malufis/bastaoIOT-Gateway/docs/project_analysis_report.md

# Relatório de Análise Completa do Projeto Bastão-ESP

Data: 2026-05-20
Versão: 1.0

---

## 1. Comunicação K10 ↔ Sensores

### ✅ Implementado
| Funcionalidade | Status | Arquivo |
|---|---|---|
| Leitura do acelerômetro SC7A20 | ✅ OK | `hal_sensors.c` |
| Detecção de movimento (threshold 0.15g) | ✅ OK | `main.c` K10 |
| Envio de acelerômetro via Mesh | ✅ OK | `k10_mesh_node.c` |
| Recebimento no Bastão-ESP | ✅ OK | `stm32_uart.c` |
| Validação de leitura com movimento | ✅ OK | `main.c` ESP32 |

### 📊 Fluxo
```
K10: hal_sensors_read_accel() → check_movement() → k10_mesh_send_accel()
                                                    ↓
Bastão-ESP: stm32_uart_parse_json() → DATA_TYPE_ACCEL → dispatcher_task
```

---

## 2. Criptografia de Dados

### ✅ Implementado
| Funcionalidade | Status | Arquivo |
|---|---|---|
| AES-256-CBC | ✅ OK | `secure_payload.c` |
| PKCS#7 Padding | ✅ OK | `secure_payload.c` |
| Envio Mesh (criptografado) | ✅ OK | `mesh_coordinator.c` |
| Envio MQTT (criptografado) | ✅ OK | `mqtt_publisher.c` |

### 📋 Configuração
```c
static const uint8_t default_aes_key[AES_KEY_SIZE_BYTES] = {
    0x01, 0x23, 0x45, 0x67, 0x89, 0xAB, 0xCD, 0xEF, 0xFE, 0xDC, 0xBA,
    0x98, 0x76, 0x54, 0x32, 0x10, 0x10, 0x32, 0x54, 0x76, 0x98, 0xBA,
    0xDC, 0xFE, 0xEF, 0xCD, 0xAB, 0x89, 0x67, 0x45, 0x23, 0x01};
```

---

## 3. Configuração de APN SIM Cards

### ✅ Implementado
| Operadora | APN | Usuário | Senha |
|---|-----|---|---|
| Vivo (Brasil) | zap.vivo.com.br | vivo | vivo |

### 📍 Configuração
```c
static const simcom_apn_config_t default_apn = {
    .apn = "zap.vivo.com.br",
    .user = "vivo",
    .password = "vivo",
};
```

### ⚠️ Pendente
- [ ] Adicionar mais operadoras (TIM, Claro, Oi)
- [ ] Implementar seleção automática de APN por SIM
- [ ] Suporte a múltiplos perfis APN (dual SIM)

---

## 4. Servidor MQTT

### ✅ Implementado
```c
static const mqtt_publisher_config_t default_mqtt_config = {
    .broker_uri = "mqtt://broker.example.com:1883",
    .topic_telemetry = "bastao/telemetria",
    .topic_gps = "bastao/gps",
    .client_id = "bastao-esp-001",
};
```

### ⚠️ Pendente
- [ ] Configurar broker de produção (URI real)
- [ ] Configurar autenticação (TLS)
- [ ] Configurar tópico de comandos `bastao/cmd`

---

## 5. Troca de Conectividade (Wi-Fi ↔ Celular)

### ✅ Implementado
| Funcionalidade | Status | Arquivo |
|---|---|---|
| Wi-Fi STA | ✅ OK | `wifi_driver.c` |
| Conexão PPP SIMCom | ✅ OK | `simcom_ppp.c` |
| Troca automática Wi-Fi → Celular | ✅ OK | `main.c` |
| Suspensão PPP quando Wi-Fi ativo | ✅ OK | `simcom_ppp_set_suspended()` |
| Watchdog de reconexão | ✅ OK | `simcom_ppp_watchdog_start()` |

### 📋 Lógica de Troca
```
1. Wi-Fi obtém IP → simcom_ppp_set_suspended(true)
2. Wi-Fi perde conexão → simcom_ppp_set_suspended(false)
3. Watchdog tenta reconectar PPP
```

---

## 6. Dados de Erro da Rede Celular

### ❌ NÃO Implementado - GAP CRÍTICO

| Dado | Status | Necessário |
|---|---|---|
| Código de erro AT | ❌ Faltando | Sim |
| Timeout de conexão | ❌ Faltando | Sim |
| Falha de registro na rede | ❌ Faltando | Sim |
| Queda de link PPP | ❌ Faltando | Sim |
| Falha de autenticação APN | ❌ Faltando | Sim |

**Necessário implementar:** Captura de erros via comandos AT:
- `AT+CMEE=1` - Enable erros detalhados
- Parse de `+CME ERROR:` e `+CMS ERROR:`

---

## 7. Qualidade de Sinal e Tecnologia de Rede

### ❌ NÃO Implementado - GAP CRÍTICO

| Dado | Status | Necessário |
|---|---|---|
| CSQ (RSSI) | ❌ Faltando | Sim |
| Tecnologia (4G/LTE/NB-IoT) | ❌ Faltando | Sim |
| Operator Name | ❌ Faltando | Não |
| Cell ID | ❌ Faltando | Não |
| RSRP/RSRQ (4G) | ❌ Faltando | Não |

**Necessário implementar:**
```c
// Qualidade de sinal
AT+CSQ
// Resposta: +CSQ: <rssi>,<ber>

// Tecnologia de rede
AT+CPSI?
// Resposta: +CPSI: <system mode>,<operate mode>,<band>,<channel>,<pcid>,<rsrp>,<rsrq>,<rssnr>,<pathloss>
```

---

## 8. Troca de Chips SIM (Dual SIM)

### ❌ NÃO Implementado - GAP CRÍTICO

O SIMCom 7663E supports dual SIM, mas não há implementação para:
- [ ] Seleção de SIM ativo
- [ ] Troca automática por falha
- [ ] Configuração de APN por SIM
- [ ] Monitoramento de status de cada SIM

---

## 9. Resumo de Gap Analysis

### Funcionalidades Implementadas ✅
1. ✅ Leitura RFID (WL-134 + YRM100)
2. ✅ Monitoramento de bateria
3. ✅ Criptografia AES-256-CBC
4. ✅ BLE Mesh K10 ↔ Bastão
5. ✅ MQTT com queue
6. ✅ Cache offline SPIFFS
7. ✅ OTA HTTPS
8. ✅ Wi-Fi STA com fallback celular
9. ✅ Alertas (buzzer)
10. ✅ Modos de sono
11. ✅ Validação de leitura com acelerômetro

### Funcionalidades Pendentes ❌
1. ❌ CSQ (qualidade de sinal)
2. ❌ Tecnologia de rede (4G/LTE/NB-IoT)
3. ❌ Captura de erros detalhados
4. ❌ Dual SIM (troca de chips)
5. ❌ Múltiplas APN configuradas

---

## 10. Recomendação para Testes

Antes de iniciar os testes de campo, recomenda-se:

1. **Implementar CSQ e tecnologia** - Necessário para diagnóstico
2. **Implementar captura de erros** - Necessário para debug
3. **Configurar APN real** - Substituir "zap.vivo.com.br" pela APN correta
4. **Configurar MQTT real** - Substituir "broker.example.com" pelo broker real

---

## 11. Próximas Etapas Propostas

### Phase 21: Monitoramento de Rede Celular
- [ ] Implementar leitura de CSQ
- [ ] Implementar detecção de tecnologia
- [ ] Implementar captura de erros AT
- [ ] Adicionar logs de rede para debug

### Phase 22: Suporte Dual SIM (Opcional)
- [ ] Implementar seleção de SIM
- [ ] Implementar fallback entre SIMs

---

*Documento gerado em: 2026-05-20*
*Versão: 1.0*
