malufis/bastaoIOT-Gateway/docs/k10/instruções/Instrução ESP Bastao.docx

Vamos trabalhar com esp32 para integração de dados através do sistema de comunicação entre 2 esp32.

A ideia é termos um esp32 que faz a leitura dos dados e envia para um outro esp32 pelo protocolo ESP-MESH onde precisamos definir, se usamos com wifi ou com bluetooth o mesh.

A captura de dados é feito com uma integração entres esp32 e stm32 que se comunicam entre eles pela porta serial ttl.

O esp32 é responsável por toda a parte de conectividade e o stm32 por toda a parte de sensoriamento. Os sensores serão leitores de sinais rfid. Teremos 2 modelos de leitores de rfid, conectado ao stm32 por porta serial ttl, que enviaram dados para o esp32 de tags.

Definição das funcionalidades do STM32

- O Stm32 é responsável em conectar modulo de rfid com a porta serial ttl do leitor de RFID modelo YRM100, com o arquivo anexo com nome Communication user Protocol V2.1_en.docx, que tem toda a documentação do leitor. O Outro leitor é o WL-134, com o arquivo anexo com nome RFID reader module.pdf que são responsáveis pela leitura das tags em tecnologias de leituras distintas.
- O leitor yrm100 será conectado na serial PA0 e PA1 e o wl-134 na serial PA9 e PA10 no mcu STM32G070CBTx que tem o manual técnico no link: https://www.st.com/resource/en/datasheet/stm32g070cb.pdf Para fazer a energizar os módulos yrm100 e o wl-134, é necessário ativar porta digitais com nível logico alto vão está ligado e nível logico baixo desligado. O yrm100 está na porta PB5 e o wl-134 na porta PB4.
- Os módulos tem que enviar o uuid das tags para o esp32 que será responsável de armazenar, processar e disponibilizar os dados via conectividade.
- A porta PB1 é responsável pelo monitoramento da tensão da bateria com circuito resistivo dom r1 de 100k e r2 de 10k.
- Criar um agente que é capaz de tratar de toda a programação dos módulos de rfid com o stm32 para o envio dos dados para o esp32, via porta ttl conectada entre o stm32 e esp32 nas portas PA2 e PA3.

Definição das funcionalidades do ESP32

- Conectividade:
  - O esp32 se comunica com uma tela K10 por meio da tecnologia mesh definida no escopo do projeto. A tela é o endpoint e o modulo deste projeto é o coordenador.
  - O esp32 está ligado via porta serial 17 e18 a um modulo simcom 7663E para a comunicação por celular para os envios dos dados a um servidor mqtt na nuvem.
    - O modulo 7663e é responsável pela conectividade e pela posição gps/glonnas
    - O modulo 7663e usar a tecnologia ppp para ativar a comunicação com o servidor.
    - O esp32 trabalhara com a conectividade do 7663e por ppp e conseguira fazer a comunicação com o servidor mqtt, utilizando a pilha de conectividade do 7663e.
    - Toda as configurações de apn, servidor operadora entre outros sera de responsabilidade do esp32 que enviara os comandos necessários para o modulo 4g poder operar de forma correta.
  - Todos os dados que serão enviados para a tela ou para o servidor serão criptografados com aes padrão do esp32.
  - Utilizaremos o padrão json para o envio dos dados.
  - Toda a comunicação de configuração será feita por protocolo mqtt criptografada.
  - Os módulos esp32 da rede mesh poderão se comunicar entre si e trocar dados entre eles de forma assíncrona.
  - Usaremos o freertos para o sistema. Usaremos o idf da espressif para o desenvolvimento.
- Criar agentes para poder tratar de forma independente cada tipo de mcu, o eps32 e o simcom 7663e

Boas práticas

- Usar boas práticas de programação em C
- Documentar todas as funções.
- Utilizar sempre prototipagem.
- Separar em pasta sempre que preciso os arquivos

Criar um agente para as boas práticas de programação em C.
