malufis/bastaoIOT-Gateway/docs/k10/instruções/Instrução tela k10.docx

agora vamos fazer o planejamento da etapa 2.

Nesta etapa, iremos trabalhar na montagem das telas.
A navegação das telas será pelos botões da K10.

para navegar entre as telas é só apertar, botão para cima vamos para a direita e botão para baixo para a esquerda. Quanto ficarmos 3 segundos do botão de cima pressionado acessar os dados da tela. Depois navegamos com os botões, para cima sobe e para baixo desce. E sempre ter um ícone ou uma linha para sair. Usar a técnica dos 3 segundos para selecionar alguma função dentro da tela.

Primeiro precisamos desligar todos os leds que temos, não iremos usar.

A estrutura das telas são: Tela inicial, Configuração da conectividade, Configuração do dispositivo, Informações do dispositivo.

1. Na tela inicial vamos dividir ela em 3 linhas:
  a. Linha superior iremos mostrar: Icone conectividade celular 4G/3G, será o primeiro ícone superior direito. Icone WiFi alo lado da conectividade 4G, Icone de conectividade do RFID: UHF ou LF/RF, e por último Icone do gps/Glonass.
  b. No meio iremos mostrar: O nome: Fazenda raptor Nome do animal: Boi Bandido Horário da leitura: 25/04/2026 as 07:75 Localização: -20.444203671069168, -54.61944353080301
  c. Na linha inferior iremos mostrar: o inclinômetro x,y,z, depois a tensão da bateria. E um botão de Sync.
  d. Dividir a tela na seguinte proporção de altura Superior 1 – Meio 5 – Inferior 2.
2. Na tela Configuração da conectividade:
  a. Vamos fazer uma lista de configurações:
  b. No 4g/3G:
    i. Apn.
    ii. Operadora.
  c. No WiFi
    i. Nome do SSID
    ii. Estado da conexão
  d. No modulo de RFID
    i. Ativar – UHF ou LR/RF.
    ii. Potência do UHF
  e. No modulo GPS/GLONNAS
    i. Ativar GPS ou GLONNAS
3. Na Tela de Configuração do dispositivo:
  a. Configuração do app
    i. Sincronização
    ii. Ativação de dispositivo
  b. Lista de arquivos
    i. Quantidade de arquivos na memoria
    ii. Quantidade de memória livre
  c. Envio
    i. Enviar arquivo por demanda
  d. Servidor
    i. Estado do servidor
4. Na tela Informações do dispositivo
  a. Vamos fazer uma lista de informações:
    i. Versão do firmware.
    ii. Quantidade de Satélites.
    iii. Potência do sinal GPS/GLONNAS
    iv. Potência do sinal 4G/GSM
    v. Potência do UHF.
    vi. Cliente conectado.
