malufis/bastaoIOT-Gateway/stm32_firmware/Core/Inc/main.h

#define WL134_PWR_PIN GPIO_PIN_4
#define WL134_PWR_PORT GPIOB
#define YRM100_PWR_PIN GPIO_PIN_5
#define YRM100_PWR_PORT GPIOB
#define BUZZER_PIN GPIO_PIN_6
#define BUZZER_PORT GPIOB
#define CMD_BUFFER_SIZE 256
#define HEARTBEAT_INTERVAL_MS 25000
#define HEARTBEAT_FIRST_MS 5000
#define LED_STATUS_PORT GPIOB
#define LED_STATUS_PIN GPIO_PIN_3
