malufis/bastaoIOT-Gateway/stm32_firmware/Core/Src/main.c

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
/* Includes ------------------------------------------------------------------*/
#include "main.h"

/* USER CODE BEGIN Includes */
#include <stdio.h>
#include <string.h>
#include <stdlib.h>
#include "alerts.h"
#include "power_mgmt.h"
#include "rfid_parser.h"

/* USER CODE END Includes */

/* USER CODE BEGIN PD */
#define YRM100_POLL_MS 100

/* Modo de teste do YRM100:
   - Faz poll a cada 500ms
   - Envia dump hex dos bytes recebidos para o ESP32
   - Nao processa tags, buzzer, bateria, etc */
// #define YRM100_TEST_MODE
/* USER CODE END PD */

ADC_HandleTypeDef hadc1;

UART_HandleTypeDef huart1;
UART_HandleTypeDef huart2;
UART_HandleTypeDef huart3;
UART_HandleTypeDef huart4;

/* USER CODE BEGIN PV */
uint8_t byte_yrm100;
uint8_t byte_wl134;
uint8_t cmd_byte;
uint8_t cmd_line_buffer[CMD_BUFFER_SIZE];
volatile uint16_t cmd_line_index;

uint32_t last_battery_check = 0;
uint32_t last_heartbeat = 0;
uint32_t last_yrm100_poll = 0;

/* USER CODE END PV */

void SystemClock_Config(void);
static void MX_GPIO_Init(void);
static void MX_ADC1_Init(void);
static void MX_USART1_UART_Init(void);
static void MX_USART2_UART_Init(void);
static void MX_USART3_UART_Init(void);
static void MX_USART4_UART_Init(void);
/* USER CODE BEGIN PFP */
#ifdef YRM100_TEST_MODE
static void YRM100_TestLoop(void);
#endif
/* USER CODE END PFP */

/**
  * @brief  The application entry point.
  * @retval int
  */
int main(void)
{

  /* MCU Configuration--------------------------------------------------------*/

  /* Reset of all peripherals, Initializes the Flash interface and the Systick. */
  HAL_Init();

  /* Configure the system clock */
  SystemClock_Config();

  /* Initialize all configured peripherals */
  MX_GPIO_Init();
  MX_ADC1_Init();
  MX_USART1_UART_Init();
  MX_USART2_UART_Init();
  MX_USART3_UART_Init();
  MX_USART4_UART_Init();
  /* USER CODE BEGIN 2 */
  Alerts_Init();
  Power_Init();
  RFID_Init();
  Battery_Init();

  cmd_line_index = 0;

  HAL_GPIO_WritePin(WL134_PWR_PORT, WL134_PWR_PIN, GPIO_PIN_SET);
  HAL_GPIO_WritePin(YRM100_PWR_PORT, YRM100_PWR_PIN, GPIO_PIN_SET);

  HAL_Delay(100);

  /* Ativa RX do YRM100 ANTES de iniciar (precisa receber respostas dos comandos de configuracao) */
  HAL_UART_Receive_IT(&huart4, &byte_yrm100, 1);

  /* Inicializa YRM100: modo, regiao US/America, potencia 20dBm, salva na flash,
     le config de volta e envia para ESP32 */
  YRM100_Init();

  HAL_UART_Receive_IT(&huart3, &byte_wl134, 1);
  HAL_UART_Receive_IT(&huart2, &cmd_byte, 1);

  /* USER CODE END 2 */

  /* Infinite loop */
#ifdef YRM100_TEST_MODE
  YRM100_TestLoop();  /* nunca retorna */
#else
  while (1)
  {
    RFID_Process_YRM100();
    RFID_Process_WL134();

    Buzzer_Update();

    Command_Process();

    uint32_t now = HAL_GetTick();

    if (now - last_yrm100_poll >= YRM100_POLL_MS) {
        YRM100_SinglePoll();
        last_yrm100_poll = now;
    }

    uint32_t hb_interval = (last_heartbeat == 0) ? HEARTBEAT_FIRST_MS : HEARTBEAT_INTERVAL_MS;

    if (now - last_battery_check > 5000) {
        Battery_Read();
        last_battery_check = now;

        float v = Battery_GetVoltage();
        int volt_int = (int)v;
        int volt_frac = (int)((v - volt_int) * 100.0f);
        if (volt_frac < 0) volt_frac = -volt_frac;
        char msg[128];
        sprintf(msg, "{\"type\":\"batt\",\"volt\":%d.%02d}\n", volt_int, volt_frac);
        HAL_UART_Transmit(&huart2, (uint8_t*)msg, strlen(msg), 100);

        Alerts_CheckBattery(v);
    }

    if (now - last_heartbeat > hb_interval) {
        last_heartbeat = now;
        char hb[] = "{\"type\":\"heartbeat\"}\n";
        HAL_UART_Transmit(&huart2, (uint8_t*)hb, strlen(hb), 100);
    }
    /* USER CODE END WHILE */

    /* USER CODE BEGIN 3 */
  }
  /* USER CODE END 3 */
#endif /* YRM100_TEST_MODE */
}

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
/* USER CODE BEGIN 4 */
void HAL_UART_RxCpltCallback(UART_HandleTypeDef *huart) {
    if (huart->Instance == USART4) {
        RFID_StoreByte(byte_yrm100, 1);
        HAL_UART_Receive_IT(&huart4, &byte_yrm100, 1);
    } else if (huart->Instance == USART3) {
        RFID_StoreByte(byte_wl134, 0);
        HAL_UART_Receive_IT(&huart3, &byte_wl134, 1);
    } else if (huart->Instance == USART2) {
        if (cmd_byte == '\n' || cmd_byte == '\r') {
            if (cmd_line_index > 0) {
                cmd_line_buffer[cmd_line_index] = '\0';
                Alerts_ProcessCommand((const char*)cmd_line_buffer);
                cmd_line_index = 0;
            }
        } else if (cmd_line_index < CMD_BUFFER_SIZE - 1) {
            cmd_line_buffer[cmd_line_index++] = cmd_byte;
        }
        HAL_UART_Receive_IT(&huart2, &cmd_byte, 1);
    }
}

void Command_Process(void) {
    static uint8_t last_buzzer_state = 0;
    uint8_t current_buzzer = Buzzer_IsActive() ? 1 : 0;

    if (current_buzzer != last_buzzer_state) {
        last_buzzer_state = current_buzzer;
    }

    if (Alerts_IsBatteryCritical()) {
        char led_state = (HAL_GetTick() / 500) % 2;
        HAL_GPIO_WritePin(LED_STATUS_PORT, LED_STATUS_PIN,
            led_state ? GPIO_PIN_SET : GPIO_PIN_RESET);
    } else {
        HAL_GPIO_WritePin(LED_STATUS_PORT, LED_STATUS_PIN, GPIO_PIN_RESET);
    }
}

#ifdef YRM100_TEST_MODE
static void YRM100_TestLoop(void)
{
    uint8_t raw[256];
    uint16_t len;
    char hex[512];
    char json[600];
    uint32_t last_test_poll = 0;

    while (1) {
        uint32_t now = HAL_GetTick();
        if (now - last_test_poll < 500) {
            // Processa RX interrupt enquanto espera
            continue;
        }
        last_test_poll = now;

        // Descarrega buffer residual antes do comando
        YRM100_FlushBuffer();

        // Envia comando 0x22 (single poll)
        uint8_t cmd[] = {0xBB, 0x00, 0x22, 0x00, 0x00, 0x22, 0x7E};
        HAL_UART_Transmit(&huart4, cmd, sizeof(cmd), 100);

        // Aguarda ate 200ms por dados
        uint32_t start = HAL_GetTick();
        while ((HAL_GetTick() - start) < 200) {
            if (RFID_HasData(1)) break;
        }

        // Le todos os bytes brutos do buffer
        len = YRM100_ReadRawBuffer(raw, sizeof(raw));

        if (len == 0) {
            char msg[] = "{\"type\":\"yrm100_test\",\"status\":\"no_response\"}\n";
            HAL_UART_Transmit(&huart2, (uint8_t*)msg, strlen(msg), 100);
        } else {
            // Monta hex dump
            int pos = 0;
            for (uint16_t i = 0; i < len && pos < (int)sizeof(hex) - 10; i++) {
                int n = sprintf(hex + pos, "%02X ", raw[i]);
                if (n > 0) pos += n;
            }
            if (pos > 0) hex[pos - 1] = '\0'; // remove trailing space
            else hex[0] = '\0';

            sprintf(json, "{\"type\":\"yrm100_test\",\"len\":%d,\"hex\":\"%s\"}\n", len, hex);
            HAL_UART_Transmit(&huart2, (uint8_t*)json, strlen(json), 100);
        }
    }
}
#endif /* YRM100_TEST_MODE */

/* USER CODE END 4 */
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
