malufis/bastaoIOT-Gateway/esp32_firmware/main/ble_mobile.h

/**
 * @file ble_mobile.h
 * @brief Cabecalho do modulo de comunicacao Bluetooth (BLE) com aplicativo
 *        de celular via GATT Server.
 * @details Este modulo implementa um servidor GATT seguro no ESP32 para
 *          permitir que um aplicativo movel (Android/iOS) sincronize dados
 *          de configuracao do bastao e dados de negocio (Fazenda, Lote, Animal)
 *          de forma bidirecional e criptografada.
 *
 * @author Antigravity Agent
 * @date 2026-05-20
 */

#ifndef BLE_MOBILE_H
#define BLE_MOBILE_H

#include "esp_err.h"
#include <stdbool.h>
#include <stdint.h>

#ifdef __cplusplus
extern "C" {
#endif

#include "simcom_driver.h"

/* --- Definicoes de UUIDs do Servico GATT --- */

/**
 * @brief UUID base customizado do servico GATT do Bastao-ESP.
 * @details Formato: XXXXXXXX-BAST-4A0E-8F2D-BASTAO00ESP32
 *          Os primeiros 4 bytes sao substituidos pelo UUID especifico.
 */
#define BASTAO_SERVICE_UUID        0x00FF  /**< UUID do servico principal */
#define CHAR_CONFIG_WRITE_UUID     0xFF01  /**< Config escrita (app -> bastao) */
#define CHAR_CONFIG_READ_UUID      0xFF02  /**< Config leitura (bastao -> app) */
#define CHAR_BUSINESS_WRITE_UUID   0xFF03  /**< Dados de negocio (app -> bastao) */
#define CHAR_LAST_TAG_UUID         0xFF04  /**< Ultima tag lida (notify -> app) */
#define CHAR_DEVICE_STATUS_UUID    0xFF05  /**< Status do dispositivo (read) */
#define CHAR_CELLULAR_STATUS_UUID  0xFF06  /**< Status celular (read/notify) */
#define CHAR_LOGGER_UUID           0xFF07  /**< Log de debug (write/read) */

/* --- Tamanhos de Buffer --- */

/** @brief Tamanho maximo do payload de uma caracteristica GATT. */
#define BLE_MOBILE_ATTR_MAX_LEN    512

/** @brief Tamanho maximo do nome do dispositivo BLE. */
#define BLE_MOBILE_DEVICE_NAME_LEN 32

/* --- Chaves NVS para Persistencia --- */

#define NVS_NAMESPACE_CONFIG       "bastao_cfg"
#define NVS_NAMESPACE_BUSINESS   "bastao_biz"
#define NVS_KEY_FARM             "farm_data"
#define NVS_KEY_LOT              "lot_data"
#define NVS_KEY_ANIMAL           "animal_data"
#define NVS_KEY_YRM100_POWER     "yrm_power"
#define NVS_KEY_SCAN_TIME        "scan_time"
#define NVS_KEY_WIFI_SSID        "wifi_ssid"
#define NVS_KEY_WIFI_PASSWORD    "wifi_pass"
#define NVS_KEY_WIFI_ENABLED     "wifi_en"
#define NVS_KEY_APN              "apn"
#define NVS_KEY_APN_USER         "apn_user"
#define NVS_KEY_APN_PASSWORD     "apn_pass"
#define NVS_KEY_CELLULAR_ENABLED "cell_en"
#define NVS_KEY_MQTT_URI         "mqtt_uri"
#define NVS_KEY_MQTT_CLIENT_ID   "mqtt_client"
#define NVS_KEY_MQTT_TOPIC_TELE   "mqtt_tele"
#define NVS_KEY_MQTT_TOPIC_GPS    "mqtt_gps"
#define NVS_KEY_NETWORK_MODE     "net_mode"
#define NVS_KEY_BIZ_JSON         "biz_json"
#define NVS_KEY_CFG_JSON        "cfg_json"
#define NVS_KEY_SIM_IMEI         "sim_imei"
#define NVS_KEY_SIM0_MSISDN      "sim0_msisdn"
#define NVS_KEY_SIM1_MSISDN      "sim1_msisdn"
#define NVS_KEY_SIM0_CCID        "sim0_ccid"
#define NVS_KEY_SIM1_CCID        "sim1_ccid"
#define NVS_KEY_SIM0_OPERATOR    "sim0_oper"
#define NVS_KEY_SIM1_OPERATOR    "sim1_oper"

/* --- Estruturas de Dados --- */

/**
 * @brief Estrutura representando os parametros de configuracao do bastao.
 */
typedef struct {
    uint8_t yrm100_power;    /**< Potencia de transmissao do YRM100 (0-26 dBm) */
    uint16_t scan_time_ms;   /**< Tempo de varredura de tags em milissegundos */
    uint8_t battery_report_interval_s; /**< Intervalo de telemetria de bateria */
    bool wl134_enabled;      /**< Habilitar/desabilitar leitor LF WL-134 */
    bool yrm100_enabled;     /**< Habilitar/desabilitar leitor UHF YRM100 */
} bastao_config_t;

/**
 * @brief Estrutura representando o status atual do dispositivo.
 */
typedef struct {
    float battery_voltage;
    bool cellular_connected; /**< Conectividade celular MQTT ativa */
    bool mqtt_connected;
    bool mesh_active;
    bool gps_fix;
    double gps_latitude;
    double gps_longitude;
    uint32_t tags_read_count;
    uint8_t movement_detected;
    float accel_x;
    float accel_y;
    float accel_z;
    bool sim_present;        /**< Flag de presenca do chip SIM */
    int active_sim_slot;     /**< Slot de chip ativo (0 ou 1) */
    char sim_ccid[32];       /**< Identificador unico do chip SIM (ICCID) */
    char sim_imei[32];       /**< IMEI do modulo celular */
    char sim_msisdn[2][20];  /**< Numero de telefone do slot 0 e 1 */
    char sim_operator[2][32];/**< Operadora detectada por slot */
    int sim_rssi[2];         /**< Ultimo RSSI (dBm) por slot */
    bool stm32_alive;        /**< STM32 responsivo (heartbeat recebido) */
    /* --- Dados recebidos da K10 (BLE Mesh) --- */
    float k10_battery_voltage;       /**< Tensao da bateria da K10 */
    uint8_t k10_battery_percentage;  /**< Porcentagem da bateria da K10 */
    uint8_t k10_battery_critical;    /**< Bateria K10 em nivel critico */
    uint8_t k10_screen_active;       /**< Tela K10 ativa/acesa */
    uint8_t k10_battery_valid;       /**< Dados de bateria K10 atualizados */
} bastao_device_status_t;

/**
 * @brief Modo de conectividade de rede do dispositivo.
 */
typedef enum {
    NETWORK_MODE_WIFI_ONLY = 0,
    NETWORK_MODE_CELLULAR_ONLY = 1,
    NETWORK_MODE_WIFI_CELLULAR = 2,
    NETWORK_MODE_AUTO = 3
} network_mode_t;

/**
 * @brief Estrutura de configuracao de Wi-Fi.
 */
typedef struct {
    char ssid[32];
    char password[64];
    bool enabled;
} wifi_config_t;

/**
 * @brief Estrutura de configuracao de APN celular.
 */
typedef struct {
    char apn[64];
    char user[32];
    char password[32];
    bool enabled;
} cellular_config_t;

/**
 * @brief Estrutura de configuracao MQTT.
 */
typedef struct {
    char broker_uri[128];
    char client_id[32];
    char topic_telemetry[64];
    char topic_gps[64];
} mqtt_config_t;

/**
 * @brief Estrutura completa de configuracao de rede.
 */
typedef struct {
    wifi_config_t wifi;
    cellular_config_t cellular;
    mqtt_config_t mqtt;
    network_mode_t mode;
} network_config_t;

/* --- Variaveis Globais --- */

/**
 * @brief Configuracao atual do bastao (acessivel por outros modulos).
 */
extern bastao_config_t bastao_current_config;

/**
 * @brief Status atualizado do dispositivo (preenchido pelo main loop).
 */
extern bastao_device_status_t bastao_current_status;

/**
 * @brief Buffer da ultima tag lida para notificacao via BLE.
 */
extern char ble_last_tag_json[BLE_MOBILE_ATTR_MAX_LEN];

/**
 * @brief Configuracao de rede atual (Wi-Fi, Celular, MQTT).
 */
extern network_config_t bastao_network_config;

/* --- Funcoes de Interface Publica --- */

/**
 * @brief Inicializa o servidor GATT BLE para comunicacao com app movel.
 * @details Registra o servico GATT, suas caracteristicas, configura o GAP
 *          com pareamento seguro (autenticacao + criptografia) e inicia
 *          o advertising para descoberta pelo app.
 *
 * @param[in] device_name Nome do dispositivo BLE visivel no scan (ex: "Bastao-001").
 *
 * @pre O controlador Bluetooth e o Bluedroid devem estar inicializados
 *      (feito pelo mesh_coordinator_init).
 * @post O ESP32 esta anunciando via BLE e aceitando conexoes do app.
 *
 * @return esp_err_t ESP_OK se o servidor GATT foi registrado com sucesso.
 */
esp_err_t ble_mobile_init(const char *device_name);

/**
 * @brief Atualiza a caracteristica de ultima tag lida e notifica o app.
 * @details Chamada pelo dispatcher quando uma nova tag e lida, para que
 *          o app conectado receba a notificacao em tempo real.
 *
 * @param[in] tag_json String JSON da tag (ex: {"model":"YRM100","tag":"ABCD..."}).
 *
 * @return esp_err_t ESP_OK se a notificacao foi enviada.
 */
esp_err_t ble_mobile_notify_tag(const char *tag_json);

/**
 * @brief Atualiza a caracteristica de status do dispositivo.
 * @details Deve ser chamada periodicamente pelo main loop para manter
 *          o app informado sobre o estado do bastao.
 *
 * @param[in] status Ponteiro para a estrutura de status atualizada.
 *
 * @return esp_err_t ESP_OK se o status foi atualizado.
 */
esp_err_t ble_mobile_update_status(const bastao_device_status_t *status);

/**
 * @brief Carrega a configuracao salva no NVS Flash para a RAM.
 * @details Recupera os parametros de configuracao previamente gravados
 *          pelo app e preenche a estrutura bastao_current_config.
 *
 * @return esp_err_t ESP_OK se a configuracao foi carregada.
 *                   ESP_ERR_NOT_FOUND se nao houver config salva (usa defaults).
 */
esp_err_t ble_mobile_load_config_from_nvs(void);

/**
 * @brief Verifica se ha um dispositivo movel conectado via BLE.
 *
 * @return true se um app esta conectado ao GATT Server.
 */
bool ble_mobile_is_connected(void);

/**
 * @brief Carrega a configuracao de rede do NVS.
 * @return ESP_OK se carregou, ESP_ERR_NOT_FOUND se usar defaults.
 */
esp_err_t ble_mobile_load_network_config(void);

/**
 * @brief Salva a configuracao de rede no NVS.
 * @param config Ponteiro para a configuracao.
 * @return ESP_OK se salvou com sucesso.
 */
esp_err_t ble_mobile_save_network_config(const network_config_t *config);

esp_err_t ble_mobile_process_network_json(const char *json);

/**
 * @brief Processa JSON de configuracao de hardware recebido do app.
 * @param json String JSON com campos de configuracao de hardware.
 * @return ESP_OK se processou com sucesso.
 */
esp_err_t ble_mobile_process_hardware_json(const char *json);

/**
 * @brief Processa um JSON de configuracao (seja hardware ou rede) e persiste no NVS.
 * @param json String JSON contendo as chaves de configuracao.
 * @return ESP_OK se processado e salvo com sucesso.
 */
esp_err_t ble_mobile_process_config_json(const char *json);

/**
 * @brief Aplica a configuracao de rede (reiniciei componentes).
 * @details Chamada apos salvar nova configuracao para aplicar
 *          as alteracoes (reconectar Wi-Fi, MQTT, etc).
 * @return ESP_OK se aplicou com sucesso.
 */
esp_err_t ble_mobile_apply_network_config(void);

/**
 * @brief Envia notificacao do status celular ao app conectado.
 * @details Usada para reportar RSSI, tecnologia, operador em tempo real.
 *
 * @return ESP_OK se a notificacao foi enviada ou nao havia cliente conectado.
 */
esp_err_t ble_mobile_notify_cellular_status(void);

/**
 * @brief Envia mensagem de log via BLE para o app conectado.
 *
 * @param[in] log_str String de log formatada.
 * @return ESP_OK se a notificacao foi enviada.
 */
esp_err_t ble_mobile_notify_log(const char *log_str);

/**
 * @brief Habilita/desabilita o logging via BLE.
 *
 * @param[in] enable true para habilitar.
 */
void ble_mobile_log_enable(bool enable);

/**
 * @brief Verifica se o logging BLE esta ativo.
 *
 * @return true se logging BLE esta ativo.
 */
bool ble_mobile_log_is_enabled(void);

/**
 * @brief Salva dados dos chips SIM (IMEI, MSISDN, ICCID) na NVS.
 * @return esp_err_t ESP_OK se salvo com sucesso.
 */
esp_err_t ble_mobile_save_sim_data(void);

/**
 * @brief Carrega dados dos chips SIM da NVS para o status.
 * @return esp_err_t ESP_OK se carregou dados.
 */
esp_err_t ble_mobile_load_sim_data(void);

#ifdef __cplusplus
}
#endif

#endif /* BLE_MOBILE_H */
