malufis/bastaoIOT-Gateway/stm32_firmware/Core/Inc/power_mgmt.h

/**
 * @file power_mgmt.h
 * @brief Modulo de gerenciamento de energia (versao simplificada, sem sleep)
 */
#ifndef POWER_MGMT_H
#define POWER_MGMT_H

#include "main.h"

void Power_Init(void);

#endif // POWER_MGMT_H
