malufis/bastaoIOT-Gateway/esp32_firmware/main/cmd_parser.h

/**
 * @file cmd_parser.h
 * @brief Modulo de parsing de comandos remotos via MQTT
 *
 * Processa comandos recebidos no topico `bastao/cmd` para controle
 * remoto do hardware (potencia RF, leitores, buzzer, etc).
 */
#ifndef CMD_PARSER_H
#define CMD_PARSER_H

#include "esp_err.h"
#include "mqtt_publisher.h"

esp_err_t cmd_parser_init(void);
void cmd_parser_process_message(const char *topic, const char *payload);

#endif // CMD_PARSER_H
