malufis/bastaoIOT-Gateway/esp32_firmware/main/simcom_driver.h

/**
 * @file simcom_driver.h
 * @brief Cabecalho do modulo de gerenciamento do modem celular SIMCom via comandos AT.
 * @details Este modulo encapsula toda a comunicacao de baixo nivel com o modem
 *          celular via comandos AT, incluindo registro na rede, controle de GPS,
 *          envio/recepcao de SMS e o uso do cliente MQTT nativo do modem.
 *
 * @author Antigravity Agent
 * @date 2026-06-15
 */

#ifndef SIMCOM_DRIVER_H
#define SIMCOM_DRIVER_H

#include "sdkconfig.h"
#include "esp_err.h"
#include <stdbool.h>
#include <stdint.h>
#include "freertos/FreeRTOS.h"
#include "freertos/task.h"
#include "mqtt_publisher.h" // Para definicao de mqtt_publisher_config_t

#ifdef __cplusplus
extern "C" {
#endif

/* --- Definicoes de Configuracao Fisica --- */

/** @brief Porta UART do ESP32 utilizada para comunicacao com o SIMCom 7663E. */
#define SIMCOM_UART_PORT UART_NUM_2

/** @brief Pino GPIO do ESP32 conectado ao TX do modem (ESP32 TX -> Modem RX). */
#define SIMCOM_UART_TX_PIN GPIO_NUM_17

/** @brief Pino GPIO do ESP32 conectado ao RX do modem (ESP32 RX <- Modem TX). */
#define SIMCOM_UART_RX_PIN GPIO_NUM_18

/** @brief Pino GPIO do ESP32 conectado ao PWRKEY do modem SIMCom para boot por hardware. */
#define SIMCOM_PWRKEY_PIN GPIO_NUM_4

/** @brief Baud rate da comunicacao serial com o modem SIMCom. */
#define SIMCOM_UART_BAUD_RATE 115200

/** @brief Tamanho do buffer de recepcao da UART do modem. */
#define SIMCOM_UART_BUF_SIZE 2048

/** @brief Tamanho do buffer de resposta para comandos AT. */
#define AT_RESPONSE_BUF_SIZE 512

/** @brief Tamanho maximo da string de APN. */
#define SIMCOM_APN_MAX_LEN 64

/** @brief Tamanho maximo dos campos de usuario e senha da APN. */
#define SIMCOM_AUTH_MAX_LEN 32

/* --- Estruturas de Dados --- */

/**
 * @brief Estrutura de configuracao da APN da operadora celular.
 */
typedef struct {
    char apn[SIMCOM_APN_MAX_LEN];       /**< Nome da APN (ex: "zap.vivo.com.br") */
    char user[SIMCOM_AUTH_MAX_LEN];      /**< Usuario da APN (vazio se nao necessario) */
    char password[SIMCOM_AUTH_MAX_LEN];  /**< Senha da APN (vazio se nao necessario) */
} simcom_apn_config_t;

/**
 * @brief Estrutura contendo dados de localizacao GPS.
 */
typedef struct {
    bool valid;        /**< Flag indicando se a posicao e valida */
    double latitude;   /**< Latitude decimal (positivo = Norte, negativo = Sul) */
    double longitude;  /**< Longitude decimal (positivo = Leste, negativo = Oeste) */
    float altitude;    /**< Altitude em metros acima do nivel do mar */
    float speed_kmh;   /**< Velocidade em km/h */
} simcom_gps_data_t;

/**
 * @brief Enumeracao dos estados operacionais do modem.
 */
typedef enum {
    SIMCOM_STATE_OFF,               /**< Modem desligado ou nao inicializado */
    SIMCOM_STATE_AT_READY,          /**< Modem respondendo a comandos AT */
    SIMCOM_STATE_REGISTERED,        /**< Modem registrado na rede celular e APN ativa */
    SIMCOM_STATE_MQTT_CONNECTED,    /**< Cliente MQTT integrado conectado ao Broker */
    SIMCOM_STATE_ERROR              /**< Estado de erro ou falha de comunicacao */
} simcom_state_t;

/**
 * @brief Enumeracao das tecnologias de rede celular suportadas.
 */
typedef enum {
    CELLULAR_TECH_NONE = 0,   /**< Sem rede */
    CELLULAR_TECH_2G,         /**< GSM/GPRS 2G */
    CELLULAR_TECH_3G,         /**< UMTS/HSPA 3G */
    CELLULAR_TECH_4G_LTE,     /**< LTE 4G */
    CELLULAR_TECH_NB_IOT,     /**< NB-IoT (LTE Cat NB1/NB2) */
    CELLULAR_TECH_UNKNOWN     /**< Tecnologia desconhecida */
} cellular_tech_t;

/**
 * @brief Estrutura contendo o status completo da rede celular.
 */
typedef struct {
    int rssi;                  /**< RSSI em dBm (-113 a -51) ou 99 se nao detectavel */
    int ber;                   /**< BER (Bit Error Rate) ou -1 se nao disponivel */
    cellular_tech_t tech;      /**< Tecnologia de rede atual */
    int mcc;                   /**< Codigo do pais movel (Mobile Country Code) */
    int mnc;                   /**< Codigo da rede movel (Mobile Network Code) */
    int lac;                   /**< Codigo da area de localizacao (Location Area Code) */
    int cid;                   /**< Cell ID (identificador da celula) */
    char operator_name[32];    /**< Nome da operadora */
    bool registered;          /**< Flag indicando registro na rede */
    bool roaming;             /**< Flag indicando roaming */
    uint32_t tx_bytes;         /**< Reservado para estatisticas (Bytes transmitidos) */
    uint32_t rx_bytes;         /**< Reservado para estatisticas (Bytes recebidos) */
    simcom_state_t modem_state;/**< Estado operacional do modem */
    int rsrp;                  /**< RSRP em dBm (LTE) */
    int rsrq;                  /**< RSRQ em dB (LTE) */
    int sinr;                  /**< SINR/RSSNR em dB (LTE) */
    char ceer[64];             /**< Log de erro estendido (AT+CEER) */
} cellular_status_t;

/* --- Funcoes de Interface Publica --- */

/**
 * @brief Inicializa o driver UART para comunicacao com o modem SIMCom.
 * @details Configura a porta serial UART2, instala o driver e ativa a task
 *          de recebimento e o watchdog celular.
 *
 * @return esp_err_t ESP_OK se o modem responder ao comando AT inicial.
 */
esp_err_t simcom_driver_init(void);

/**
 * @brief Configura a APN da operadora celular e registra na rede.
 *
 * @param[in] apn_config Ponteiro para a estrutura com dados da APN.
 * @return esp_err_t ESP_OK se o registro na rede for bem-sucedido.
 */
esp_err_t simcom_driver_configure_apn(const simcom_apn_config_t *apn_config);

/**
 * @brief Conecta o cliente MQTT integrado do modem ao Broker.
 * @details Configura o Will Topic/Msg, registra o Client ID e estabelece a sessao TCP/MQTT.
 *          Inscreve o modem nos topicos de comando e configuracao do bastao.
 *
 * @param[in] mqtt_config Ponteiro para a estrutura com parametros de conexao MQTT.
 * @return esp_err_t ESP_OK se conectado e inscrito com sucesso.
 */
esp_err_t simcom_driver_mqtt_connect(const mqtt_publisher_config_t *mqtt_config);

/**
 * @brief Encerra a conexao MQTT e para o serviço MQTT do modem.
 * @return esp_err_t ESP_OK se desconectado.
 */
esp_err_t simcom_driver_mqtt_disconnect(void);

/**
 * @brief Publica uma mensagem em um topico usando o motor MQTT integrado do SIMCom.
 *
 * @param[in] topic Topico de destino.
 * @param[in] payload Payload em formato de string.
 * @param[in] qos Nivel de qualidade de servico (QoS).
 * @return esp_err_t ESP_OK se a publicacao foi confirmada.
 */
esp_err_t simcom_driver_mqtt_publish(const char *topic, const char *payload, uint8_t qos);

/**
 * @brief Verifica se o driver SIMCom esta ocupado (mutex em uso por outro comando AT).
 * @return true se ocupado, false se disponivel para publicar.
 */
bool simcom_driver_is_busy(void);

/**
 * @brief Bloqueia ate obter o mutex do modem (para GPS优先).
 * @details Diferente de is_busy() que faz check instantaneo,
 *          esta funcao bloqueia a task ate o mutex ser liberado.
 * @param timeout_ms Tempo maximo de espera em ms
 * @return ESP_OK se obteve o mutex, ESP_ERR_TIMEOUT se timeout
 */
esp_err_t simcom_driver_lock_gps_mutex(uint32_t timeout_ms);

/**
 * @brief Libera o mutex do modem (apos simcom_driver_lock_gps_mutex).
 */
void simcom_driver_unlock_gps_mutex(void);
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
