malufis/bastaoIOT-Gateway/(commit log)

2026-05-19 docs: estruturacao inicial, manuais tecnicos, perfis de agentes e base rfid
2026-05-20 feat: implementa firmware stm32 e esp32, cache offline, ota, ble gatt, ppp celular e testes
2026-05-20 feat: implementa wifi sta e comutacao automatica de rede (redundancia)
2026-05-20 feat: implementa banco de dados de animais local e enriquecimento de telemetria
2026-05-20 refactor: reorganiza os agentes de desenvolvimento e atualiza documentação
2026-05-20 feat: Fase 21-25 - Rede, Monitoramento Celular, Sleep, Mesh e Debug
    Fase 21 - Config de Rede via App Mobile
    - Estruturas wifi/cellular/mqtt_config_t
    - GATT 0xFF01-0xFF05 para config de rede
    -ble_mobile_load/save/process_network_config()
    Fase 22 - Monitoramento Celular
    - simcom_ppp_get_signal_quality() - AT+CSQ
    - simcom_ppp_get_network_info() - AT+QNWINFO
    - cellular_status_t e GATT 0xFF06
    Fase 23 - Sleep Modes
    - STM32: Deep Sleep com RTC wake-up
    - ESP32: Light/Deep Sleep com timer/GPIO
    - esp_power_enter_light_sleep(), esp_power_enter_deep_sleep()
    Fase 24 - Testes Mesh K10
    - verify_mesh_stress.py com 7 cenarios
    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
    [alerts.c, alerts.h, ble_mobile.c, ble_mobile.h, cmd_parser.c, cmd_parser.h, esp32_log_viewer.py, esp32_logger.c]
2026-05-20 docs: Adicionar guia de compilacao COMPILATION_GUIDE.md
2026-05-20 docs: Adicionar mapeamento de repositorios - K10 em bastao-Unihker
    Local K10: D:\git\Bastao\bastao-Unihker
    Git K10: https://github.com/malufis/bastaoIOT
    Git Gateway: https://github.com/malufis/bastaoIOT-Gateway
2026-05-20 docs: Adicionar scripts de compilacao e instrucoes para ESP-IDF
    - compile.bat: Script principal de compilacao
    - compile_bypass.bat: Script alternativo
    - sdkconfig.defaults: Configuracoes padrao para ESP32
    - COMPILE_INSTRUCTIONS.md: Guia de compilacao
2026-05-20 docs: Script de compilacao para ESP-IDF v5.5.2
    Compilar manualmente:
    1. Abrir CMD
    2. cd D:\git\Bastao\Bastão-ESP\esp32_firmware
    3. idf.py set-target esp32
    4. idf.py build
    OBS: O ESP-IDF em C:\Espressif tem conflicto de pydantic
    que precisa ser corrigido antes de compilar.
2026-06-11 feat: integracao MQTT com sistemaBastao (Fase 28)
    - Topico MQTT alterado para agro/bastao/{MAC}/telemetry
    - IV aleatorio via esp_fill_random() prefixado ao ciphertext
    - Payload padronizado: id_brinco, latitude, longitude, nivel_bateria, timestamp_rtc
    - Credenciais MQTT dinamicas: username=MAC, password=chave AES hex
    - Keepalive MQTT ajustado de 10800s para 60s
    - Config centralizada via private_configs.env + generate_config.py
    - Loop de teste RFID a cada 5min (TEST CODE - remover antes da producao)
    - Script simular_envio_bastao.py para validacao do pipeline
    - Atualizado verify_mqtt_payload.py para novo formato
    - Fazenda e bastao 206EF1D4D574 cadastrados no servidor
    ⚠ TEST CODE: main.c poss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
2026-06-11 feat: Fase 29-31 - Integracao STM32-ESP32, modularizacao e monitoramento
    Fase 29: Refatoracao do firmware STM32
    - Criado rfid_parser.c/.h (parsing YRM100 + WL-134)
    - Criado battery_monitor.c/.h (ADC com media movel 8 amostras)
    - Criado circular_buffer.c/.h (buffer circular generico)
    - main.c reduzido de 705 para 570 linhas
    - main.h limpo (removido BATTERY_CRITICAL_THRESHOLD conflitante)
    - Command_Process() implementado com monitoramento de buzzer/LED
    - Heartbeat STM32 a cada 25s (evita sleep antes do envio)
    Fase 30: Robustez do pipeline STM32 -> ESP32
    - Removido test_loop_enabled (injecao RFID falsa)
    - Fila stm32_data_queue aumentada de 10 para 20 itens
    - Parser type:alert adicionado no stm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
    [partitions.csv]
2026-06-23 fix(k10): update battery icon with telemetry received via BLE Mesh and avoid overwrite by local reading
    [gui_manager.c]
2026-06-23 fix(rfid): format WL-134 dec tag with custom uint64 helper to avoid newlib-nano %llu limitations
    [rfid_parser.c]
2026-06-23 feat(battery): take 10 consecutive ADC samples and average them to stabilize STM32 battery reading
    [battery_monitor.c, battery_monitor.h]
2026-06-24 Sessão 32 — Correção Criptografia Mesh + YRM100 SetTXPower
    - K10: dispatcher_task envia JSON simples (sem AES) via BLE Mesh
    - Bateria: adicionado campo pct na mensagem batt para K10
    - STM32: YRM100_SetTXPower() implementada, chamada no boot
    - STM32: alerts.c handler para comando yrm_tx_power
    - STM32: RFID_BUFFER_SIZE 128->512
    - ESP32: system_orchestrator_task envia GPS/Cell/Status periódicos à K10
2026-06-24 Roadmap: adiciona Fase 46 — Investigacao YRM100 nao lendo tags
2026-06-26 feat: documentacao completa + correcoes finais (Sessao 44)
    - Corrigido assert xTaskGetHandle (nomes >15 chars)
    - Corrigido CMQTTREL com retry loop (10x300ms)
    - Corrigido WiFi AP config antes de esp_wifi_start()
    - Corrigido YRM100: RX antes do init, single poll 100ms
    - Aumentado BLE Mesh segment count 4->12 (ESP32 + K10)
    - Adicionado report de config YRM100 para ESP32
    - Adicionado modo de teste YRM100 (YRM100_TEST_MODE)
    - Adicionado wake da K10 por recebimento de tag
    - Timeout display K10: 120s
    - Documentacao completa em documentacao/ (6 arquivos)
    - README.md atualizado com links para documentacao/
    [partitions.csv]
2026-06-26 docs: GPS Cold Start + documentacao atualizada
    - GPS revertido de Hot Start (AT+CGNSSPWR=1,1) para Cold Start (AT+CGNSSPWR=1)
    - Documentado em documentacao/01_Arquitetura_do_Sistema.md secao GPS
    - AGENTS.md: Sessao 45 adicionada
    [simcom_driver.c]
2026-07-07 fix: buzzer I2S corrigido (bip continuo) + documentacao completa (Sessao 46)
    - Buzzer: canal I2S desabilitado entre beeps (play_tone habilita/desabilita)
    - Buzzer: pinagem corrigida BCLK=GPIO0 LRCK=GPIO38 SDO=GPIO45 MCLK=NC
    - Buzzer: DMA 2->6 descritores, silencio 8x128 samples antes do disable
    - K10: fontes reduzidas (tag_id=16, titulo=20, historico 12/18)
    - K10: beeps de boot (3 beeps sem depender de Mesh)
    - K10: SPIFFS timestamp corrigido (time(NULL) em vez de 0)
    - K10: tela tag anti-flash guard + dismiss 3s->4s
    - K10: vTaskDelay removido do loop (flicker display)
    - K10: last_x/y/z movidas para escopo compartilhado
    - Docs: AGENTS.md Sessao 46 com licoes aprendidas
    - Docs: PROJETO_BASTAO.m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
    [partitions.csv]
2026-07-07 GPS acelerado via A-GPS (AT+CAGPS) + multi-constelacao
    Sessao 47 - Aceleracao de fix GPS de 30s+ para 2-5s:
    - AT+CAGPS: download efeméride/almanac do servidor AGNSS via4G
    - AT+CGNSSMODE=7: ativa GPS+BDS+GLONASS (mais satelites)
    - URC +CGNSSPWR:READY!: espera chip GNSS pronto antes de AGPS
    - Fallback para CGNSSMODE=3 se ASR1601 nao suportar modo 7
    - AGPS tambem executado na reconexao do watchdog
    Arquivos: simcom_driver.c/h, main.c, AGENTS.md
    [main.c, simcom_driver.c, simcom_driver.h]
2026-07-08 Correcao URC AGPS (Sessao 49): AT+CAGPS retorna OK, +AGPS:success. e URC
    - simcom_driver_download_agps() corrigido: expected_resp de +AGPS: para OK
    - Handler URC +AGPS:success. e +AGPS:<erro> em process_simcom_line()
    - Semaforo agps_sem para aguardar resultado assincrono (timeout 10s)
    - Antes: sempre falhava (ret=-1). Depois: aguarda URC corretamente
    - AGENTS.md, progress.md, ROADMAP.md atualizados
    [simcom_driver.c]
2026-07-08 Correcao AGPS Sessao 50: ASR1601 sem URC READY, timeout 12s, erro 106
    - ASR1601 nao emite +CGNSSPWR:READY! (so ASR1603/1803)
    - Timeout AT+CAGPS: 3s → 12s (documentacao diz 9s max)
    - Timeout URC AGPS: 10s → 15s
    - GNSS ready timeout: 15s → 5s (URC nao existe)
    - Erro 106 tratado (timeout/servidor inacessivel)
    - Query AT+CGNSSPWR? para diagnostico
    - Logging detalhado para cada etapa
2026-07-08 Sessao 52: Verificacao de relogio + DNS pre-AGPS. check_clock() via AT+CCLK? + sync_time_from_tower(), check_dns() via AT+CDNSGIP, integrado no download_agps()
2026-07-08 Corrige retorno de download_agps(): retorna ESP_FAIL quando AGPS falha (antes retornava ESP_OK do AT+CAGPS mesmo com erro 106). Log 'A-GPS configurado com sucesso' agora so aparece quando realmente b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
    [simcom_driver.c]
2026-07-08 Adiciona AT+CGNSSPROD para diagnosticar chip GNSS no boot
2026-07-08 Sessao 55: Fallback AGPS com injecao de posicao da torre 4G + timestamp
    - Documentacao V2.04 revela AT+CAGPS=2 aceita parametros de posicao e hora!
    - Se AT+CAGPS falhar com erro 106, tenta injectar posicao da torre celular
    - Usa cached_cell_lat/lon + time(NULL) como AidPosString e AidTimeString
    - Isso acelera o fix GPS mesmo sem servidor AGNSS acessivel
    - Ex: AT+CAGPS=2," -20.4442,-54.6194\,2,\1721985946\
    [simcom_driver.c]
2026-07-08 AGENTS.md: Sessao 55 - Fallback AGPS com injecao de posicao da torre
2026-07-08 Adiciona AT+CEREG? como comando primario de registro 4G/LTE
    - wait_for_network_registration() agora tenta AT+CEREG? primeiro (4G)
    - Fallback para AT+CREG? se CEREG nao responder (2G/3G)
    - Watchdog roaming detection usa CEREG primeiro, CREG como fallback
    - Init sequence habilita CEREG=1 (antes so tinha CREG e CGREG)
    - Mantem cache Mozilla + injecao AT+CAGPS=2 como fallbacks
2026-07-08 GPS prioridade maxima: bloqueia mutex ao inves de retry polling
    - gps_reader_task agora usa simcom_driver_lock_gps_mutex(10000ms)
    - Bloqueia ATE o mutex ser liberado (em vez de retry 3x2s)
    - Garante que GPS leia mesmo com MQTT publicando frequentemente
    - Nova API: simcom_driver_lock/unlock_gps_mutex() no header
2026-07-08 Cell tower location via modem 4G (AT+HTTPINIT) ao inves de esp_http_client
    - Substitui esp_http_client (dependia de Wi-Fi) por AT+HTTPINIT do modem
    - Usa AT+HTTPDATA para POST JSON, AT+HTTPACTION para GET, AT+HTTPREAD
    - Adicionado URC handler +HTTPACTION: com semaforo http_action_sem
    - Funciona em CELLULAR_ONLY sem Wi-Fi
    - Mantem mesmo JSON do Mozilla Location Service
2026-07-08 Corrige deadlock GPS: lock_mutex + at_send_cmd no mesmo mutex
    - gps_reader_task: removeu lock_mutex separado (causava deadlock)
    - simcom_driver_get_gps: timeout AT+CGPSINFO 3s -> 15s
    - Agora GPS bloqueia esperando o mutex DENTRO do at_send_cmd, nao antes
    - log: 'Falha ao obter mutex' NAO aparece mais para GPS
    [main.c, simcom_driver.c]
2026-07-08 Inverte boot: primeiro obtem posicao torre 4G, depois dispara AGPS
    - Sequencia nova: configure_apn → update_cell_tower_cache() → download_agps()
    - update_cell_tower_cache() usa AT+HTTPINIT do modem (4G, sem Wi-Fi)
    - download_agps() agora tem cell_tower_location_valid para injetar no GPS
    - Se servidor AGNSS offline, GPS recebe posicao da torre + timestamp
